gralco/ToolHead-PCB/README.md

# ToolHead-PCB
Tool Head PCB Used for Automatic Swapping with Thermocouple Measurement and Data Storage in EEPROM
