gralco/ToolHead-PCB/bom/ToolHead_PCB_BoM.ods

Reference | Value | Footprint | Datasheet | MFG Name | MFG Part Num | Distrib PN | Qty Per | Distrib Link | Tolerance | Others
P1 | CARRIAGE | Pin_Headers:Pin_Header_Angled_2x10 | https://www.mill-max.com/assets/pdfs/metric/021.2M.PDF | Mill-Max | 499-10-220-10-007000 | ED1600-ND | 1 | http://www.digikey.com/product-search/en/connectors-interconnects/rectangular-connectors-spring-loaded/1442900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 | - | http://www.digikey.com/product-search/en/connectors-interconnects/rectangular-connectors-spring-loaded/1442900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
P2 | DOCK | Pin_Headers:Pin_Header_Angled_1x10 | https://www.mill-max.com/assets/pdfs/metric/020.2M.PDF | Mill-Max | 399-10-110-10-007000 | ED1549-ND | 1 | http://www.digikey.com/product-detail/en/mill-max-manufacturing-corp/399-10-110-10-007000/ED1549-ND/5880286 | - | http://www.digikey.com/product-search/en/connectors-interconnects/rectangular-connectors-spring-loaded/1442900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
U1 | MAX31855KASA | Power_Integrations:SO-8 | http://datasheets.maximintegrated.com/en/ds/MAX31855.pdf | Maxim | MAX31855KASA+ | MAX31855KASA+-ND | 1 | http://www.digikey.com/product-detail/en/maxim-integrated/MAX31855KASA-/MAX31855KASA--ND/2591564 | - | http://www.digikey.com/product-detail/en/analog-devices-inc/AD8226ARZ/AD8226ARZ-ND/2027816
U2 | EEPROM | TO_SOT_Packages_SMD:SOT-23-6 | http://www.digikey.com/product-detail/en/microchip-technology/25AA02UIDT-I-OT/25AA02UIDT-I-OTCT-ND/4292625 | Microchip | 25AA02UIDT-I/OT | 25AA02UIDT-I/OTCT-ND | 1 | http://www.digikey.com/product-detail/en/microchip-technology/25AA02UIDT-I-OT/25AA02UIDT-I-OTCT-ND/4292625 | - | http://www.digikey.com/product-search/en/integrated-circuits-ics/memory/2556980?k=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
P8/P9 | E-MOTOR/ENCODER | Pin_Headers:Pin_Header_Angled_1x04 | http://www.molex.com/pdm_docs/sd/705530002_sd.pdf | Molex | 705530003 | WM4902-ND | 2 | http://www.digikey.com/product-detail/en/molex-llc/0705530003/WM4902-ND/114959 | - | -
P3 | THERMO | ToolHead_PCB:THERMOCOUPLE | - | - | - | - | - | - | - | -
P4/P5/P6 | HS-FAN/E-FAN/HEAT | Pin_Headers:Pin_Header_Angled_1x02 | http://www.molex.com/pdm_docs/sd/705530001_sd.pdf | Molex | 705530001 | WM4900-ND | 3 | http://www.digikey.com/product-detail/en/molex-llc/0705530001/WM4900-ND/114951 | - | -
L1 | 2.5 kΩ@100MHz | Capacitors_SMD:C_0603 | http://ds.yuden.co.jp/TYCOMPAS/ut/detail.do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 | Taiyo Yuden | BK1608LM252-T | 587-1893-1-ND | 1 | http://www.digikey.com/product-detail/en/taiyo-yuden/BK1608LM252-T/587-1893-1-ND/1465363 | - | http://www.digikey.com/products/en/filters/ferrite-beads-and-chips/841?k=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
D1/D2 | RB751S40 | ToolHead_PCB:SOD-523F | https://www.fairchildsemi.com/datasheets/RB/RB751S40.pdf | Fairchild | RB751S40 | RB751S40CT-ND | 2 | http://www.digikey.com/product-detail/en/fairchild-semiconductor/RB751S40/RB751S40CT-ND/1969050 | - | http://www.digikey.com/product-search/en/discrete-semiconductor-products/diodes-rectifiers-single/1376383?k=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
C3 | 100nF | Capacitors_SMD:C_0603_HandSoldering | http://media.digikey.com/pdf/Data%20Sheets/Murata%20PDFs/GRM%20Series%20Data.pdf | Murata | GRM188R71H104KA93D | 490-1519-1-ND | 1 | http://www.digikey.com/product-detail/en/murata-electronics-north-america/GRM188R71H104KA93D/490-1519-1-ND/587854 | 10% | http://www.digikey.com/product-search/en/capacitors/ceramic-capacitors/131083?k=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
C4 | 10nF | Capacitors_SMD:C_0603_HandSoldering | http://www.kemet.com/Lists/ProductCatalog/Attachments/53/KEM_C1002_X7R_SMD.pdf | Kemet | C0603C103J5RACTU | 399-1092-1-ND | 1 | http://www.digikey.com/product-detail/en/kemet/C0603C103J5RACTU/399-1092-1-ND/411367 | 5% | http://www.digikey.com/product-search/en/capacitors/ceramic-capacitors/131083?k=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
C1/C2 | 15μF | Capacitors_SMD:C_0603_HandSoldering | https://product.tdk.com/info/en/documents/chara_sheet/C1608X5R0J156M080AC.pdf | TDK | C1608X5R0J156M080AC | 445-8027-1-ND | 2 | http://www.digikey.com/product-detail/en/tdk-corporation/C1608X5R0J156M080AC/445-8027-1-ND/2792157 | 20% | http://www.digikey.com/product-search/en/capacitors/ceramic-capacitors/131083?k=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
R1/R2/R3/R4 | 10kΩ | Resistors_SMD:R_0603_HandSoldering | http://www.yageo.com.tw/exep/pages/download/literatures/PYu-R_INT-thick_7.pdf | Yageo | RC0603FR-0710KL | 311-10.0KHRCT-ND | 4 | http://www.digikey.com/product-detail/en/yageo/RC0603FR-0710KL/311-10.0KHRCT-ND/729827 | 1% | http://www.digikey.com/product-search/en/resistors/chip-resistor-surface-mount/65769?mnonly=0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
