gralco/ToolHead-PCB/(list of files, cad)

Other CAD files:
toolhead_pcb.stp
