gralco/ToolHead-PCB/ToolHead_PCB.pdf

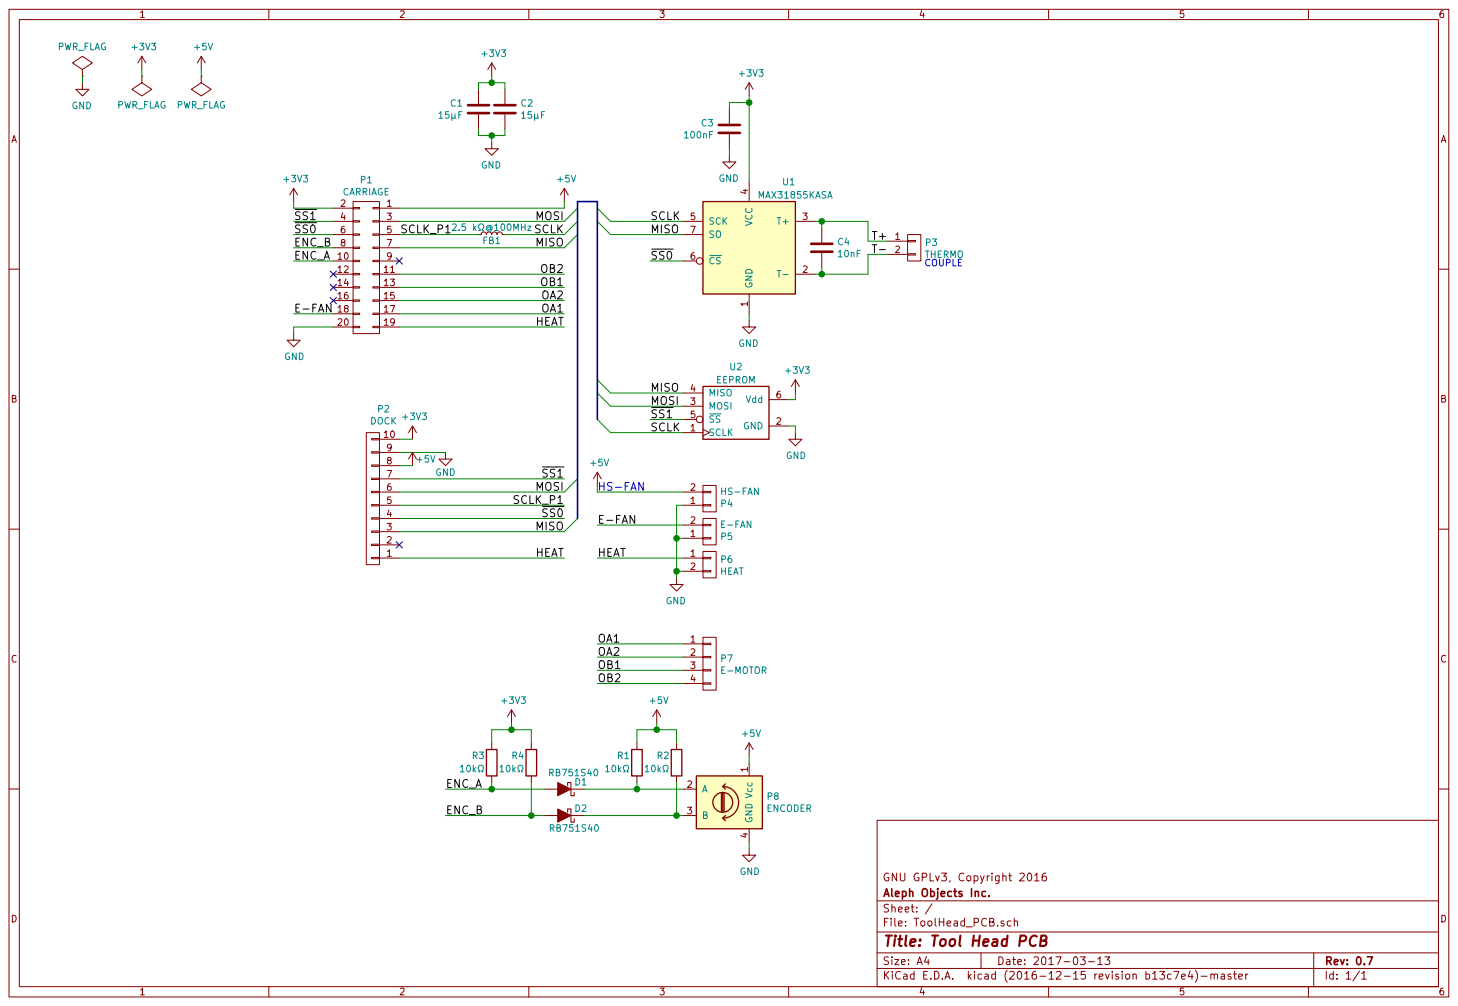
[picture p1: page 1]

8 | 7 MISO
10 | 9 OB2

GNU GPLv3, Copyright 2016
File: ToolHead_PCB.sch Sheet: / Aleph Objects Inc.

Id: 1/1 Title: Tool Head PCB
