gralco/ToolHead-PCB/ToolHead_PCB.kicad_pcb

## KiCad design ToolHead_PCB.kicad_pcb (2017-10-08)

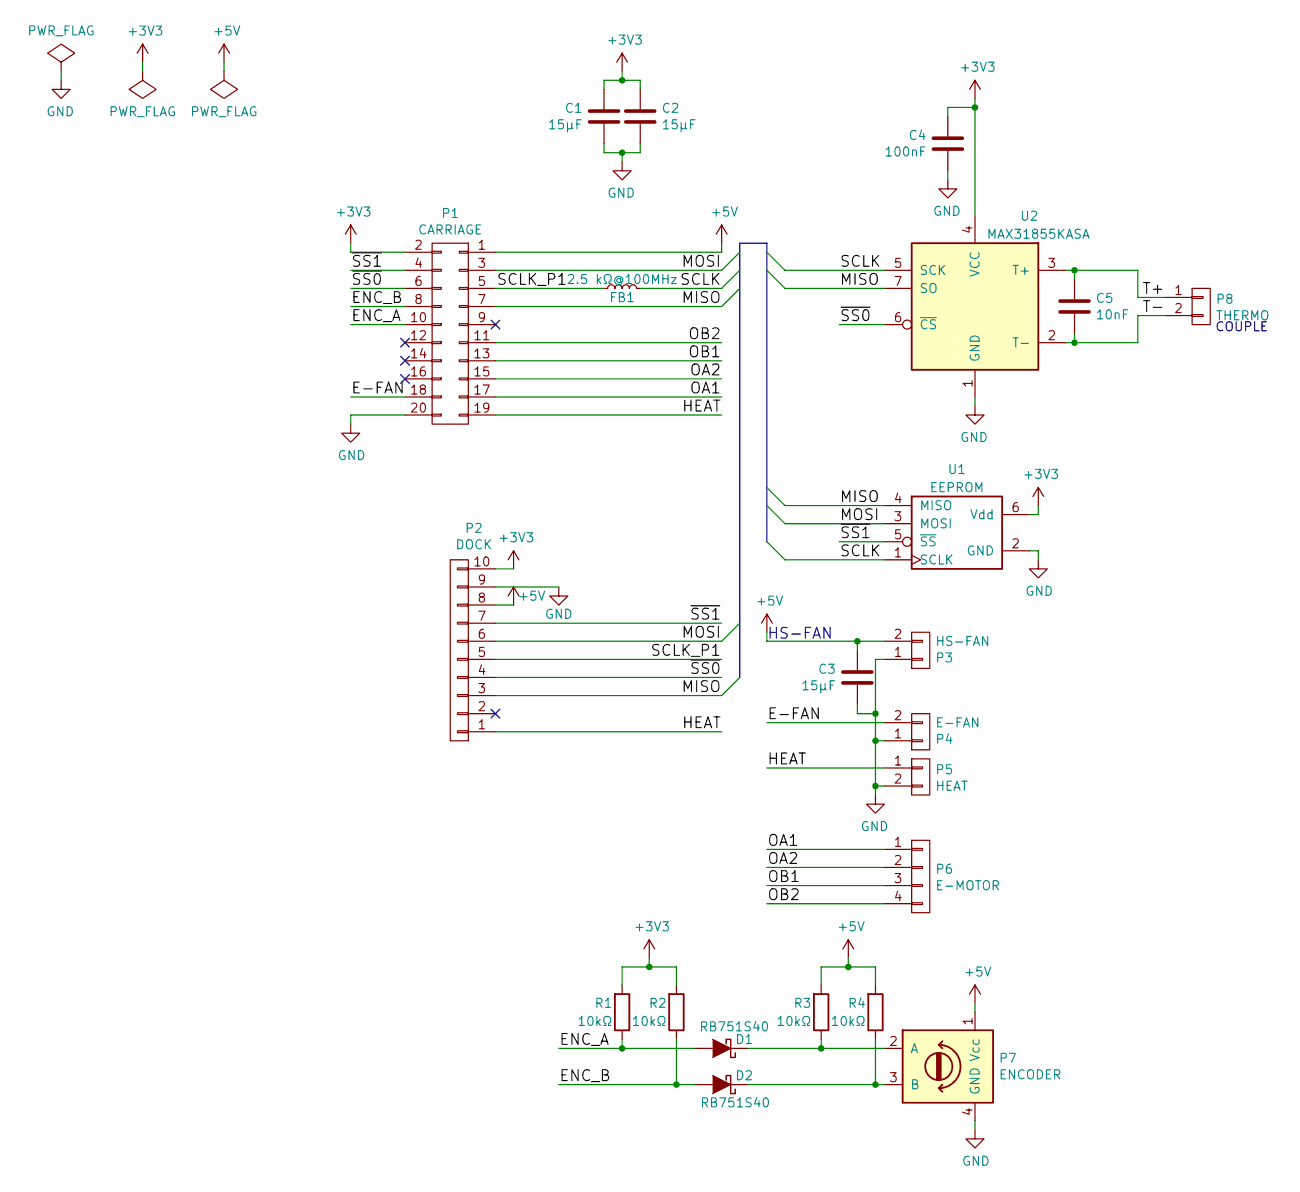
[picture p2: schematic ToolHead_PCB.sch, Tool Head PCB]

Parts:
C1, C2, C3: 15μF; C_0603_HandSoldering; Tolerance 20%; MFG Part Num C1608X5R0J156M080AC
C4: 100nF; C_0603_HandSoldering; Tolerance 10%; MFG Part Num GRM188R71H104KA93D
C5: 10nF; C_0603_HandSoldering; Tolerance 5%; MFG Part Num C0603C103J5RACTU
D1, D2: RB751S40; SOD-523F; MFG Part Num RB751S40
FB1: 2.5 kΩ@100MHz; C_0603; MFG Part Num BK1608LM252-T
P1: CARRIAGE; Pin_Header_Angled_2x10; MFG Part Num 499-10-220-10-007000
P2: DOCK; Pin_Header_Angled_1x10; MFG Part Num 399-10-110-10-007000
P3: HS-FAN; Pin_Header_Angled_1x02; MFG Part Num 0705530001
P4: E-FAN; Pin_Header_Angled_1x02; MFG Part Num 0705530001
P5: HEAT; Pin_Header_Angled_1x02; MFG Part Num 0705530001
P6: E-MOTOR; Pin_Header_Angled_1x04; MFG Part Num 0705530003
P7: ENCODER; Pin_Header_Angled_1x04; MFG Part Num 0705530003
P8: THERMO; THERMOCOUPLE
R1, R2, R3, R4: 10kΩ; R_0603_HandSoldering; Tolerance 1%; MFG Part Num RC0603FR-0710KL
U1: EEPROM; SOT-23-6; MFG Part Num 25AA02UIDT-I/OT
U2: MAX31855KASA; SO-8; MFG Part Num MAX31855KASA+

Connections:
+3V3: C1.1, C2.1, C4.1, P1.2, P2.10, R1.2, R2.2, U1.6 (Vdd), U2.4 (VCC)
+5V: C3.1, P1.1, P2.8, P3.2, P7.1 (Vcc), R3.2, R4.2
/E-FAN: P1.18, P4.2
/ENC_A: D1.2 (A), P1.10, R1.1
/ENC_B: D2.2 (A), P1.8, R2.1
/HEAT: P1.19, P2.1, P5.1
/MISO: P1.7, P2.3, U1.4 (MISO), U2.7 (SO)
/MOSI: P1.3, P2.6, U1.3 (MOSI)
/OA1: P1.17, P6.1
/OA2: P1.15, P6.2
/OB1: P1.13, P6.3
/OB2: P1.11, P6.4
/SCLK: FB1.2, U1.1 (SCLK), U2.5 (SCK)
/SCLK_P1: FB1.1, P1.5, P2.5
/T+: C5.1, P8.1, U2.3 (T+)
/T-: C5.2, P8.2, U2.2 (T-)
/~SS0: P1.6, P2.4, U2.6 (~CS~)
/~SS1: P1.4, P2.7, U1.5 (~SS)
GND: C1.2, C2.2, C3.2, C4.2, P1.20, P2.9, P3.1, P4.1, P5.2, P7.4 (GND), U1.2 (GND), U2.1 (GND)
unnamed: D1.1 (K), P7.2 (A), R3.1
unnamed: D2.1 (K), P7.3 (B), R4.1

Notes on the sheet:
HS-FAN
COUPLE

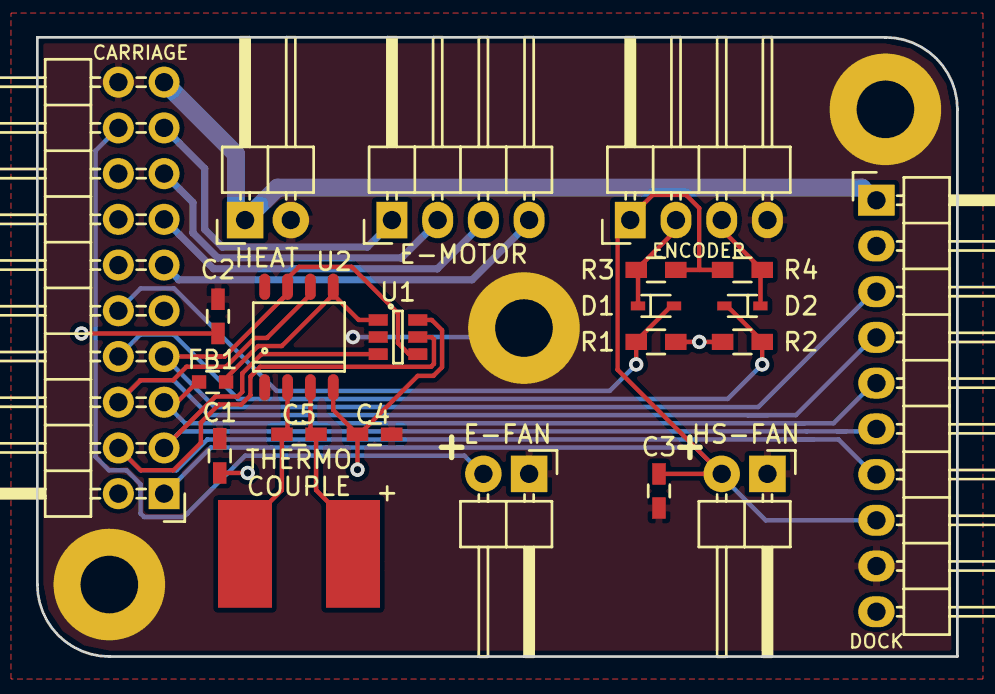
[picture p3: board ToolHead_PCB.kicad_pcb from above]

Board: 2 copper layers, 51.1 x 34.4 mm, 22 parts (0 on the bottom side), 21 nets.
