gralco/ToolHead-PCB/(notices)

Notices in the files:
ToolHead_PCB.kicad_pcb:
GNU GPLv3, Copyright 2016-2017
